mibe/BISS/Hardware/Blinky/PCB/Blinky.brd

## EAGLE design Hardware/Blinky/PCB/Blinky.brd (2018-04-21)

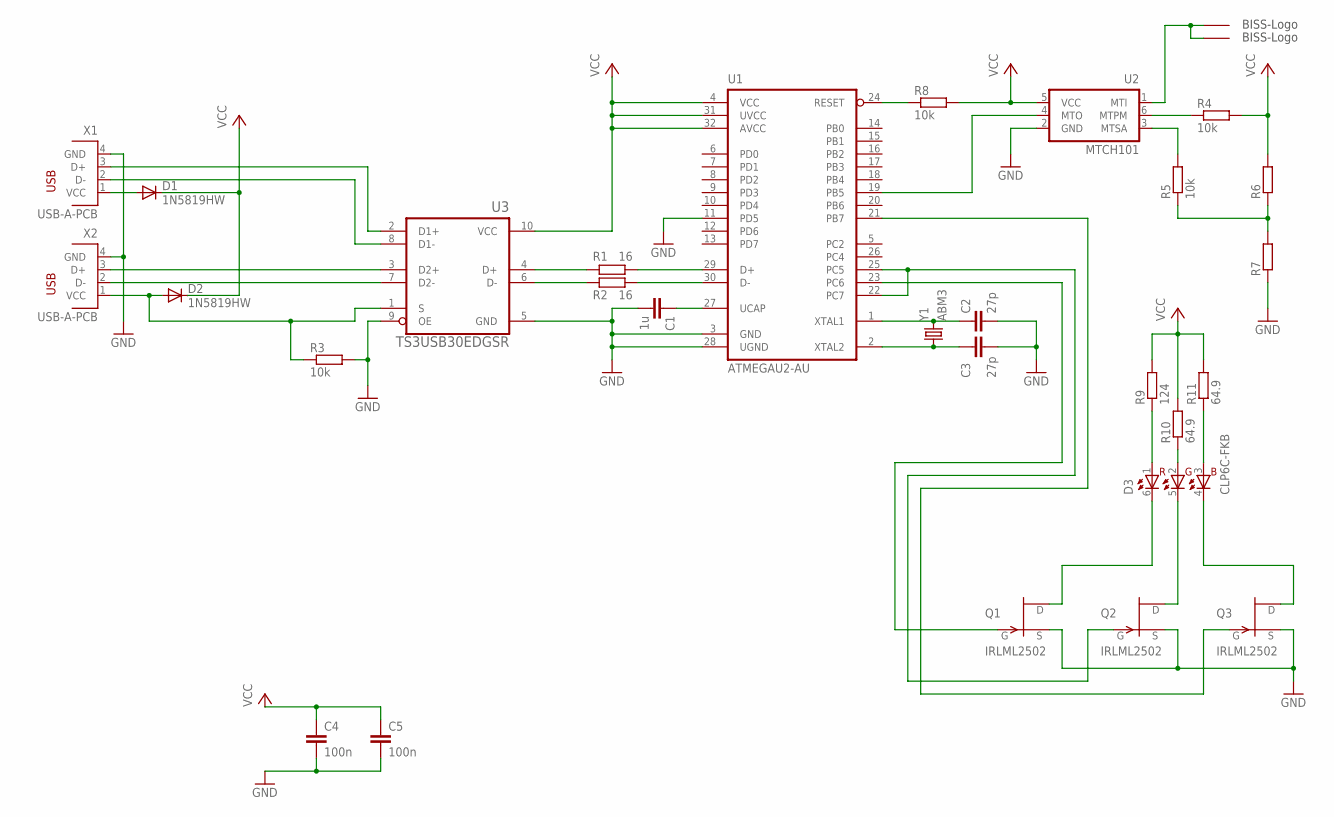
[picture p1: schematic Blinky.sch]

Parts:
C1: 1u; C0805
C2, C3: 27p; C0805
C4, C5: 100n; C0805
D1, D2: 1N5819HW; SOD123
D3: CLP6C-FKB; PLCC-6
Q1, Q2, Q3: IRLML2502; SOT23
R1, R2: 16; R0805
R3, R4, R5, R8: 10k; R0805
R6, R7: R-EU_R0805; R0805
R9: 124; R0805
R10, R11: 64.9; R0805
U1: ATMEGAU2-AU; TQFP32-08
U2: MTCH101; SOT23-6
U3: TS3USB30EDGSR; VSSOP-10
U$1, U$2: LOGO
X1, X2: USB-A-PCB
Y1: ABM3

Connections:
D1+: U3.2 (D1+), X1.3 (D+)
D1-: U3.8 (D1-), X1.2 (D-)
D2+: U3.3 (D2+), X2.3 (D+)
D2-: U3.7 (D2-), X2.2 (D-)
D+_CON: R1.1, U3.4 (D+)
D+_MIC: R1.2, U1.29 (D+)
D-_CON: R2.1, U3.6 (D-)
D-_MIC: R2.2, U1.30 (D-)
GND: C1.2, C2.2, C3.2, C4.2, C5.2, Q1.2 (S), Q2.2 (S), Q3.2 (S), R3.2, R7.1, U1.3 (GND), U1.11 (PD5), U1.28 (UGND), U2.2 (GND), U3.5 (GND), U3.9 (OE), X1.4 (GND), X2.4 (GND)
GND_LED_B: D3.4, Q3.3 (D)
GND_LED_G: D3.5, Q2.3 (D)
GND_LED_R: D3.6, Q1.3 (D)
LED_B: Q3.1 (G), U1.21 (PB7)
LED_G: Q2.1 (G), U1.22 (PC7), U1.25 (PC5)
LED_R: Q1.1 (G), U1.23 (PC6)
unnamed: R4.1, U2.6 (MTPM)
unnamed: R5.2, U2.3 (MTSA)
unnamed: R5.1, R6.1, R7.2
RESET: R8.1, U1.24 (RESET)
TOUCH: U1.19 (PB5), U2.4 (MTO)
TOUCH_PAD: U2.1 (MTI), U$1.P$1, U$2.P$1
UCAP: C1.1, U1.27 (UCAP)
VCC: C4.1, C5.1, D1.C, D2.C, R4.2, R6.2, R8.2, R9.2, R10.2, R11.2, U1.4 (VCC), U1.31 (UVCC), U1.32 (AVCC), U2.5 (VCC), U3.10 (VCC)
VUSB1: D1.A, X1.1 (VCC)
VUSB2: D2.A, R3.1, U3.1 (S), X2.1 (VCC)
V_LED_B: D3.3, R11.1
V_LED_G: D3.2, R10.1
V_LED_R: D3.1, R9.1
XTAL1: C2.1, U1.1 (XTAL1), Y1.2
XTAL2: C3.1, U1.2 (XTAL2), Y1.1

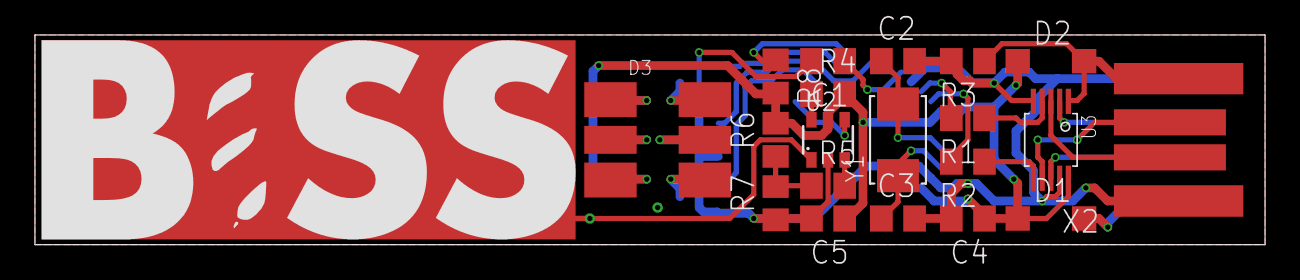
[picture p2: board Blinky.brd from above]

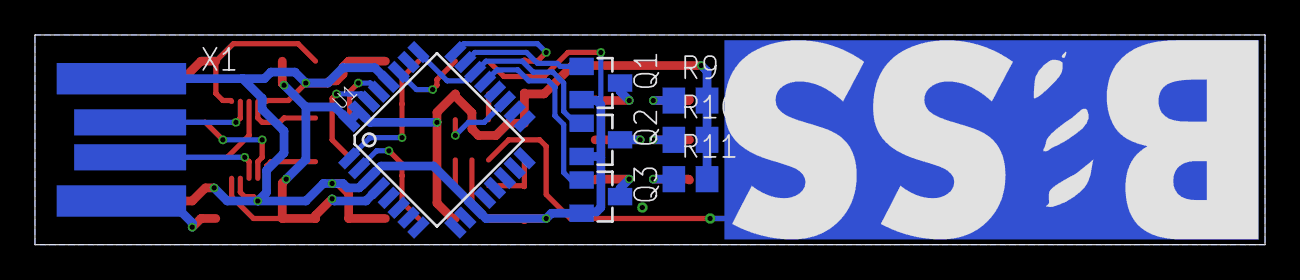
[picture p3: board Blinky.brd from below]

Board: 2 copper layers, 70.4 x 12.0 mm, 30 parts (9 on the bottom side), 30 nets.
