mibe/BISS/(threads)

Thread 5 (2017-01-26):

BISS.Blinker

mibe, 2017-01-26:
The BISS.Blinker is a device for receiving the BISS messages without a computer.

* Network connection over a ESP8266
* Designed as a rotating emergency vehicle lightning / beacon
* Has a button to stop the notification
* A timeout also stops the notification
* Power over Micro-USB

Thread 6 (2017-01-26):

Biss.Blinky

mibe, 2017-01-26:
BISS.Blinky is a small USB device for notifying the user of a new BISS message. This is done by, well, blinking an LED. :grin:

* RGB LED
* User should set the desired color and brightness
* Capacitive touch sensor for stopping the notification
* A timeout should also stop the notification
* A software controls the device (setting color / brightness, triggering the notification)

Thread 7 (2017-01-26):

BISS.Hardware

mibe, 2017-01-26:
A library for controlling hardware devices like #6 BISS.Blinky by custom HID messages.

The HID messages are tricky, since there's no native .NET API for those. A lot of PInvoke & marshalling is needed for that. There are a number of HID libaries for .NET out there, but most of them are not working (at least not with tested V-USB devices) and are poorly documented. Not to say undocumented.

Thread 9 (2017-01-26):

BISS.Buzzer

mibe, 2017-01-26:
How about a big gameshow buzzer to trigger a BISS message?

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

* Completely wireless
* Therefore a rechargeable battery: LiPo
* LiPo's are delicate devices, a proper charging / discharging circuit is needed
* Recharching over dedicated Micro-USB port
* Network communication over an ESP-8266
* Status LEDs
* How are different message types entered? Multiple presses?
* To save power, the device has to be able to disconnect itself for maximised battery life, since the ESP-8266 is power-hungry
* The user has to be notified of an un- / successful sending of a BISS message
* Integrated magnet to throw it at a whiteboard, table leg, etc...
