mibe/BISS/Hardware/Blinky/firmware/Commands.c

/*
 * BISS.Blinky: A USB device for notifying the user of a new BISS message.
 *
 * Copyright (C) 2017-2018 Michael Bemmerl
 *
 * SPDX-License-Identifier: MIT
 */

#include "Commands.h"

static void Command_Trigger(uint8_t blinkerSettings)
{
	Blinker_Enable(blinkerSettings);
}

static void Command_SetSettings(uint8_t r, uint8_t g, uint8_t b, uint8_t blinkInterval, uint8_t blinkTimeout)
{
	if (settings.Color.R != r || settings.Color.G != g || settings.Color.B != b)
	{
		settings.Color.R = r;
		settings.Color.G = g;
		settings.Color.B = b;
		Display_Update();
	}
	
	settings.BlinkInterval = blinkInterval;
	settings.BlinkTimeout = blinkTimeout;
}

static void Command_GetSettings(uint8_t* r, uint8_t* g, uint8_t* b, uint8_t* blinkInterval, uint8_t* blinkTimeout)
{
	*r = settings.Color.R;
	*g = settings.Color.G;
	*b = settings.Color.B;
	*blinkInterval = settings.BlinkInterval;
	*blinkTimeout = settings.BlinkTimeout;
}

static void Command_SaveSettings(void)
{
	// Disable the blinker after saving, too.
	Settings_Save();
	Blinker_Disable();
}

static void Command_ResetSettings(void)
{
	Settings_Clear();
}

static void Command_Bootloader(void)
{
	Bootloader_Execute();
}

static void Command_TurnOff(void)
{
	Blinker_Disable();
}

static void Command_Ping(uint8_t* p, uint8_t* o, uint8_t* n, uint8_t* g)
{
	*p = 0x50;		// P
	*o = 0x6F;		// o
	*n = 0x6E;		// n
	*g = 0x67;		// g
}

uint8_t Command_Handle(uint8_t* fromHost, uint8_t* toHost)
{
	// The command ID is always the first byte of the package.
	uint8_t cmdId = fromHost[0];
	
	// Clear array; this notation had the least memory impact.
	toHost[0] = cmdId;
	toHost[1] = 0;
	toHost[2] = 0;
	toHost[3] = 0;
	toHost[4] = 0;
	toHost[5] = 0;
	toHost[6] = 0;
	
	switch(cmdId)
	{
		case CMD_Trigger:
			Command_Trigger(fromHost[1]);
			break;
		case CMD_SetSettings:
			Command_SetSettings(fromHost[1], fromHost[2], fromHost[3], fromHost[4], fromHost[5]);
			break;
		case CMD_GetSettings:
			Command_GetSettings(&toHost[1], &toHost[2], &toHost[3], &toHost[4], &toHost[5]);
			break;
		case CMD_SaveSettings:
			Command_SaveSettings();
			break;
		case CMD_ResetSettings:
			Command_ResetSettings();
			break;
		case CMD_Bootloader:
			Command_Bootloader();
			break;
		case CMD_TurnOff:
			Command_TurnOff();
			break;
		case CMD_Ping:
			Command_Ping(&toHost[1], &toHost[2], &toHost[3], &toHost[4]);
			break;
		default:
			return 1;
	}
	
	// Pass the sync byte received back to the host.
	toHost[7] = fromHost[7];
	
	return 0;
}
