mibe/BISS/(commit log)

2017-01-23 Don't display a message box, but instead change the text of the button.
2017-02-28 Set the ReuseAddress socket option to support running multiple receivers at the same time on the same port.
2017-03-19 The Sender now needs a IP address specified, on which the UDP socket should be binded to.
    This is the groundwork for sending the BISS message on more than one interfaces (see #4 for details).
2017-03-21 Removed unused code:
    - XMEGA specific stuff
    - LED stuff
    - USB events
2017-03-21 USB device descriptor settings like VID/PID.
    Using pid.codes' test VID/PID for now.
2017-03-22 First bits of the display driver.
2017-03-27 Store user settings in EEPROM.
    The blinking frequency and the LED color is currently saved.
2017-04-09 Bugfix: blue LED was not disabled correctly.
    PB7 is on port B and not on port C of course.
    [Display.c]
2017-04-16 Blink algorithm.
    This is using Timer0 in pseudo CTC mode.
    CTC is implemented in software by using the timer overflow interrupt.
    The algorithm is also using a GPIO register for storing a status bit.
2017-04-23 Functions for returning the current state of the settings and to clear them.
    This information can be used by the controlling application on the host computer to inform the user that the device is not configured.
2017-04-25 The first four commands from the USB host to the device are implemented.
    That is the trigger command and the save, set and reset settings command.
    [Blinky.c, Blinky.h, Commands.c, Commands.h]
2017-05-15 Monitor the pin connected to the touch sensor to disable the blinker.
2017-05-15 The touch sensor input can now be disabled when specified by the host.
2017-10-30 Don't use the Pin Change Interrupt to monitor the touch sensor output.
    That thing didn't work properly, because after a triggered interrupt, data send from the USB host wasn't received. I don't know why, and after two hours of debugging I decided to ditch that interrupt.
    [Blinker.c, Blinker.h, Commands.c]
2017-11-26 First rough cut of the hardware library described in issue #7.
    It currently fully supports the BISS.Blinky device.
2017-11-26 Support for setting a communication timeout between the USB host & device.
2017-11-26 New command for turning off a triggered device.
2017-11-28 The Device class is now thread-safe.
2018-02-05 Schematic for the BISS Blinky.
    Still missing: The correct resistor values for the touch sensor and the sensor pad itself.
    [Blinky.sch]
2018-03-04 Most of the PCB layout is done.
    Still missing is the touch sensor disguised as logo (hello issue #10).
    [Blinky.brd, Blinky.sch]
2018-03-07 Changed the series resistance on the USB lines to 16 Ohm.
    The USB switch U3 is introducing some additional resistance in the on state.
    [Blinky.brd, Blinky.sch]
2018-04-16 Imported the BISS logo into the Blinky PCB.
    This also determined the final size of the PCB.
    [Blinky.brd, Blinky.sch]
2018-04-21 Added ground pour on both sides and moved some traces and vias around.
    [Blinky.brd]
2018-04-21 No cream on the logo pad.
    [Blinky.brd, Blinky.sch]
2018-05-06 Gerber & Excellon files which were sent to the fab house
2018-06-28 Someone (read: I) forgot the pull-down resistors at the gates at the MOSFETs. 😳
    This bug is fixed in software: The timer which provides the PWM signal to the gate is stopped when the LED should be off and started again when it should be on again. The pin is at all times configured as output.
    [Display.c]
